jesperKarlfeldt/VO2_Mask/arduino v1.1/README.md

Code and other info related to arduino v1.1
