jesperKarlfeldt/VO2_Mask/Images/3Mmask.jpg

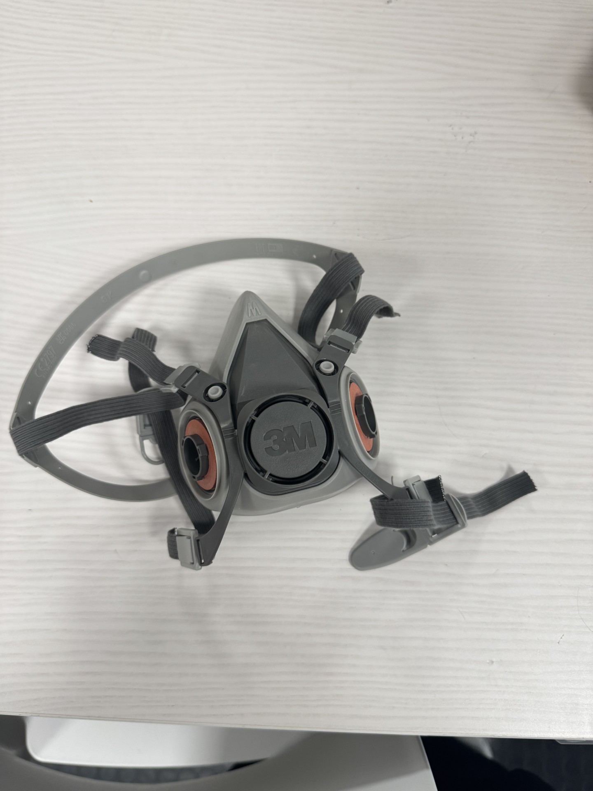
Images/3Mmask.jpg
