jesperKarlfeldt/VO2_Mask/Images/KablageEfter (1).jpg

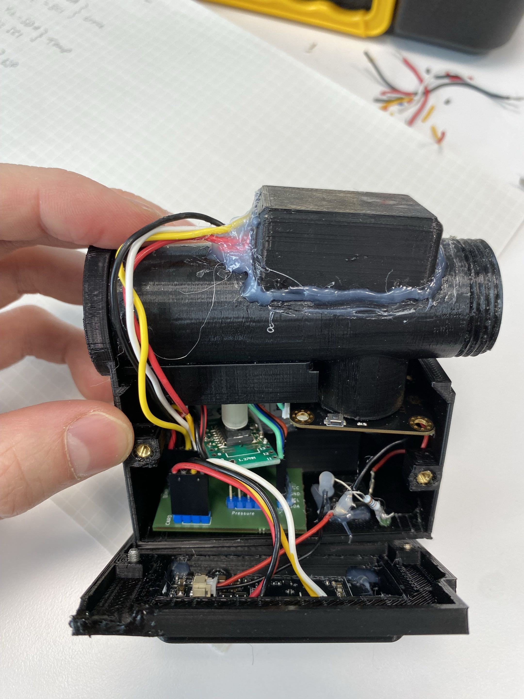
Images/KablageEfter (1).jpg
