jesperKarlfeldt/VO2_Mask/Images/PCB (1).png

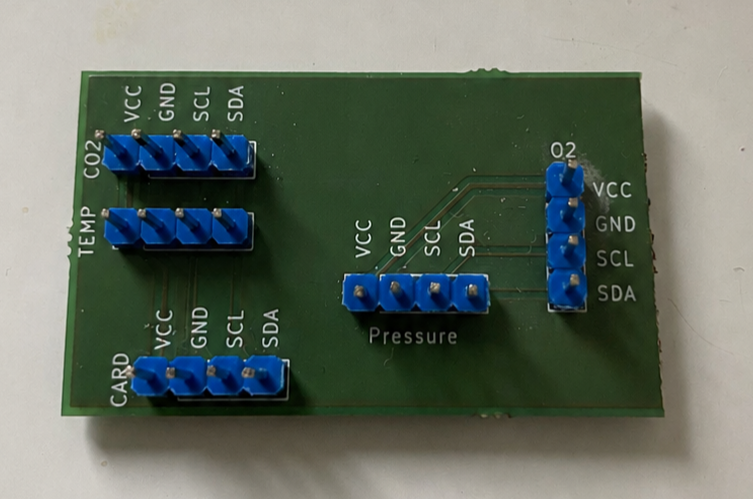
Images/PCB (1).png
