jesperKarlfeldt/VO2_Mask/BOM.md

## Bill of Materials

### USA

| Item | Description/Details | Source | Est Cost |
| --- | --- | --- | --- |
| board (the brain) | ESP32 T-Display, 16MB CH9102F | [Amazon](https://www.amazon.com/gp/product/B099MPFJ9M/) | $19 |
| battery| Lipo Battery, 1000 Mah, E503450 3.7v |  [Amazon](https://www.amazon.com/gp/product/B07BTV3W87/ref=ox_sc_act_title_1?smid=A132D7PL1YID8X&psc=1) | $12 |
| pressure sensor | BMP280, calculate air density |  [Amazon](https://www.amazon.com/gp/product/B01ICN5QPU/ref=ox_sc_act_title_1?smid=A30QSGOJR8LMXA&psc=1) | $6 |
| screws | 2 x M3 x 8mm | [Amazon](https://www.amazon.com/Hilitchi-510-Pcs-Button-Socket-Assortment/dp/B073SWNV5N/) | $15 for kit |
| threaded inserts (original design only) | M3 x 8 x 5mm | [Amazon](https://www.amazon.com/gp/product/B096MD67WB/) | $18 for kit |
| aquarium tubing (original design only) | standard 3/16", 4mm inside diameter (ID) |  [Amazon](https://www.amazon.com/AQUANEAT-Standard-Airline-Aquarium-PREMIUM/dp/B01N8SNNOI/) | $6 |
| o-ring | for oxygen sensor, 22x19x1.5mm | [Amazon](https://www.amazon.com/uxcell-Silicone-Rings-Diameter-Gasket/dp/B082STZ4XL?th=1) | $7 for 30 |
| jumper wire | for making board-sensor connections | [Amazon](https://www.amazon.com/TUOFENG-Hookup-Wires-6-Different-Colored/dp/B07TX6BX47?th=1) | $15 |
| oxygen sensor | Gravity: I2C Oxygen Sensor |  [DF Robot](https://www.dfrobot.com/product-2052.html) | $75 |
| differential pressure sensor | Omron--D6F-PH0025AD2 |  [Digikey](https://www.digikey.com/en/products/detail/omron-electronics-inc-emc-div/d6f-ph0025amd2/15197363) | $28 |
| cable for diff press sensor | DF-CABLE3 |  [Digikey](https://www.digikey.com/en/products/detail/omron-electronics-inc-emc-div/D6F-CABLE3/9471785) | $12 |
| mask | half mask, particulate matter, 6200/07025 | [Digikey](https://www.digikey.com/en/products/detail/3m/6200-07025/7693860) | $22 |
| CO2 sensor | SCD30 |  [Digikey](https://www.digikey.com/en/products/detail/sensirion-ag/SCD30/8445334) | $62 |
| on/off switch | mini push button |  [Adafruit](https://www.adafruit.com/product/1683)| $6 |

### EU

| Item | Description/Details | Source | Est Cost (€) |
| --- | --- | --- | --- |
| board (the brain) | ESP32 T-Display, 16MB CH9102F | [Amazon](https://www.amazon.de/-/en/gp/product/B099MPFJ9M) | €23 |
| battery| Lipo Battery, 1000 Mah, E503450 3.7v |  [Amazon](https://www.amazon.de/-/en/gp/product/B09GK98KZK) | €18 |
| diff pressure sensor | SM9233-BCE-S-250-002, calculate air density | [Mouser](https://www.mouser.se/ProductDetail/TE-Connectivity-SMI/SM9336-BCE-S-250-000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) | $47 |
| screws | 2 x M3 x 8mm | [Amazon](https://www.amazon.de/-/en/340pcs-Stainless-Screws-Button-Assortment/dp/B08H24T1DJ) | €9 for kit |
| threaded inserts (original design only) | M3 x 8 x 5mm | [Amazon](amazon.de/gp/product/B09ZHSGHXD) | tbd |
| aquarium tubing (original design only) | standard 3/16", 4mm inside diameter (ID) | [eBay](http://ebay.de/itm/183220505584?var=691579886173) | tbd |
| Silicone Tubing | 2mm ID x 4mm OD |  [Amazon](https://www.amazon.com/Quickun-Silicone-Brewing-Kegerator-Aquaponics/dp/B08BRJS5GD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) | $6 |
| o-ring | for oxygen sensor, 22x19x1.5mm | [Amazon](https://www.amazon.de/-/en/gp/product/B00AKW4MM0) | €5 for 10 |
| jumper wire | for making board-sensor connections | [eBay1](ebay.de/itm/184844268251) [eBay2](ebay.de/itm/184844268251) | tbd |
| oxygen sensor | Gravity: I2C Oxygen Sensor |  [Mouser](https://eu.mouser.com/ProductDetail/426-SEN0322) | €49 |
| mask | half mask, particulate matter, 6200/07025 | [Amazon](https://www.amazon.de/-/en/gp/product/B005HK05L2) | €21 |
| CO2 sensor | SCD30 |  [Mouser](https://www.mouser.se/ProductDetail/Mikroe/MIKROE-4725?qs=Li%252BoUPsLEnsKaKlNBnHiog%3D%3D) | €110 |
| on/off switch | mini push button |  [Mouser](https://eu.mouser.com/ProductDetail/Adafruit/1683)| €2 |

Prices are rounded and exclude VAT.
