jesperKarlfeldt/VO2_Mask/3d-print-files/v1/MainBody.3mf

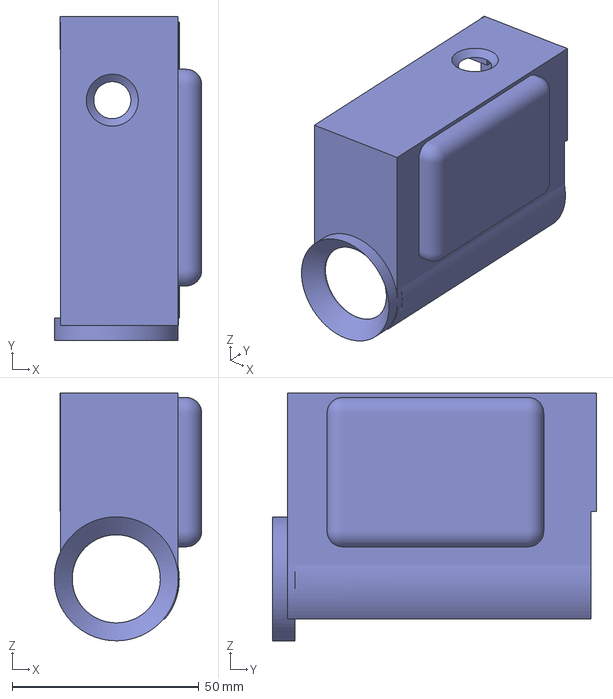
[picture p9: CAD file, 2026-05-20]
3d-print-files/v1/MainBody.3mf
39.5 x 86.8 x 66.3 mm
