jesperKarlfeldt/VO2_Mask/3d-print-files/v1/button.3mf

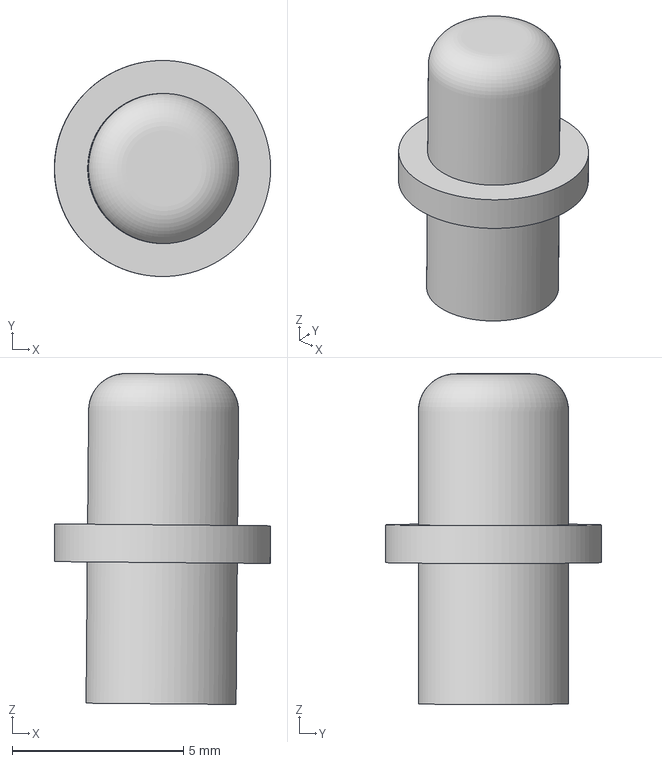
[picture p10: CAD file, 2026-05-20]
3d-print-files/v1/button.3mf
6.31 x 6.30 x 9.66 mm
