jesperKarlfeldt/VO2_Mask/3d-print-files/v1/CO2_upgrade/Venturi CO2 16mm.3mf

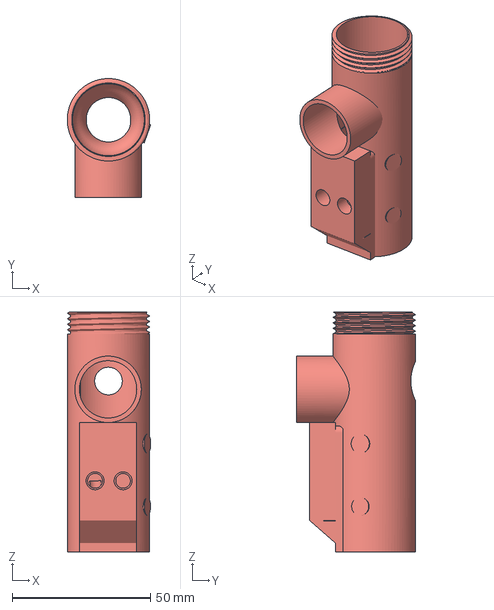
[picture p11: CAD file, 2026-05-20]
3d-print-files/v1/CO2_upgrade/Venturi CO2 16mm.3mf
30.2 x 43.0 x 86.8 mm
