jesperKarlfeldt/VO2_Mask/3d-print-files/v1/CO2_upgrade/SCD30 Cover.3mf

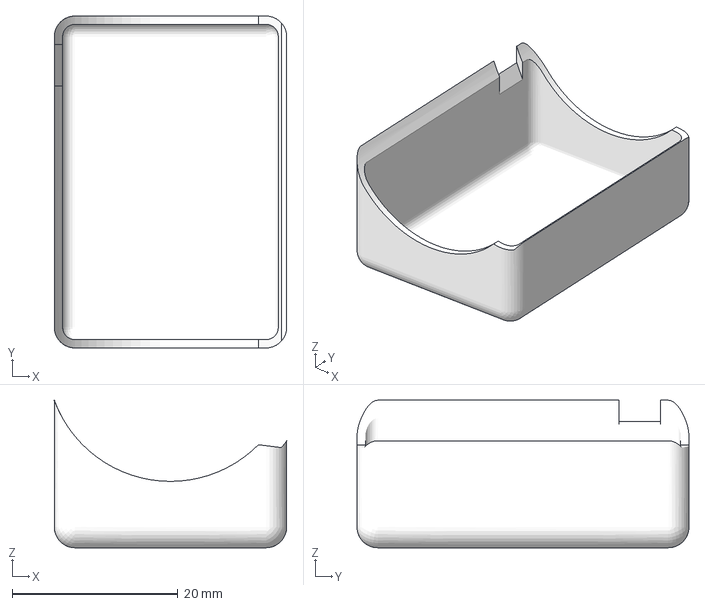
[picture p12: CAD file, 2026-05-20]
3d-print-files/v1/CO2_upgrade/SCD30 Cover.3mf
28.0 x 40.0 x 17.8 mm
