jesperKarlfeldt/VO2_Mask/3d-print-files/v1/MaskAttachment.3mf

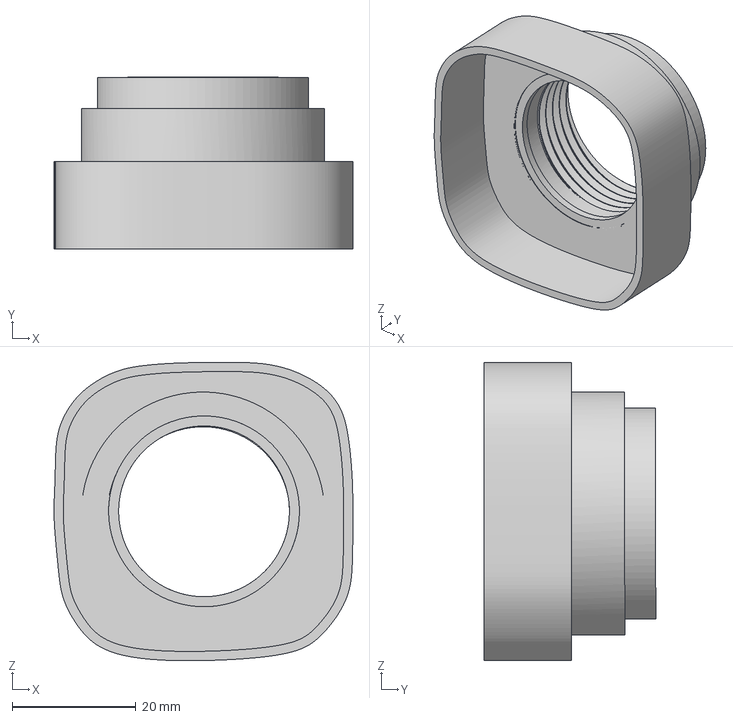
[picture p13: CAD file, 2026-05-20]
3d-print-files/v1/MaskAttachment.3mf
48.2 x 27.7 x 48.2 mm
