jesperKarlfeldt/VO2_Mask/3d-print-files/v1/ComputerCover.3mf

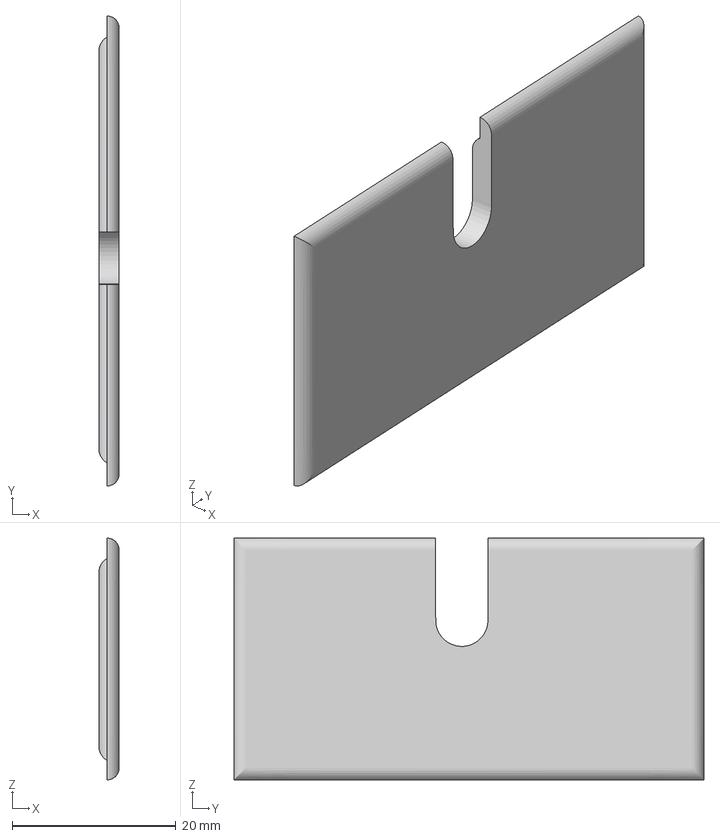
[picture p14: CAD file, 2026-05-20]
3d-print-files/v1/ComputerCover.3mf
2.49 x 57.5 x 29.6 mm
