jesperKarlfeldt/VO2_Mask/3d-print-files/v1/buttonHousing.3mf

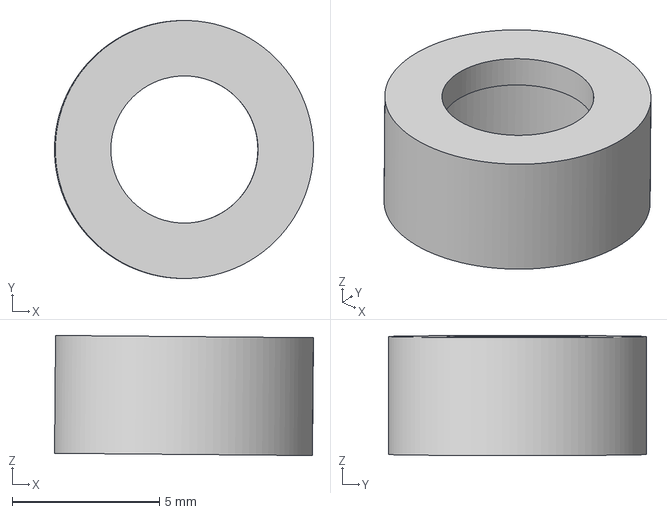
[picture p15: CAD file, 2026-05-20]
3d-print-files/v1/buttonHousing.3mf
8.79 x 8.75 x 4.08 mm
