jesperKarlfeldt/VO2_Mask/3d-print-files/v1/SideComputer.3mf

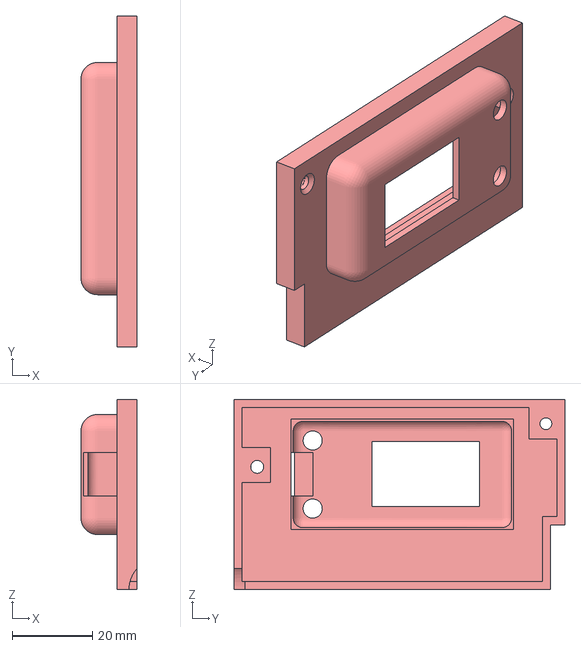
[picture p16: CAD file, 2026-05-20]
3d-print-files/v1/SideComputer.3mf
14.0 x 82.6 x 47.6 mm
