jesperKarlfeldt/VO2_Mask/(list of files, cad)

Other CAD files:
3d-print-files/v1/CO2_upgrade/Venturi CO2 20mm.3mf
3d-print-files/v1/VenturiSensor.3mf
