jesperKarlfeldt/VO2_Mask/papers/VO2MaxMask_presentation.pdf

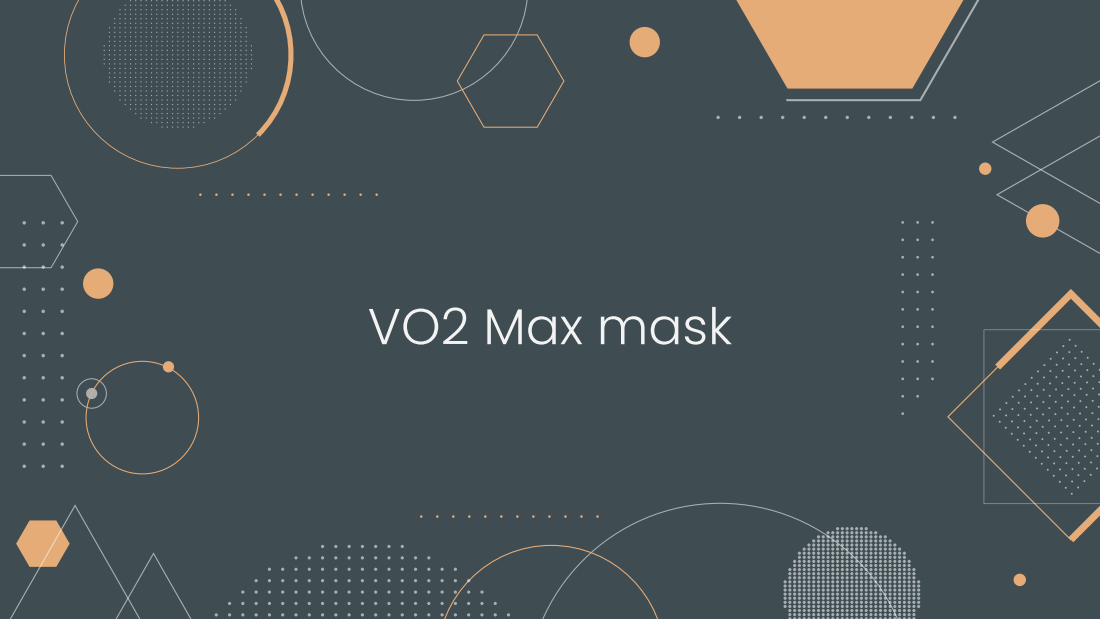
[picture p17: page 1]
VO2 Max mask

### Project Introduction

01.

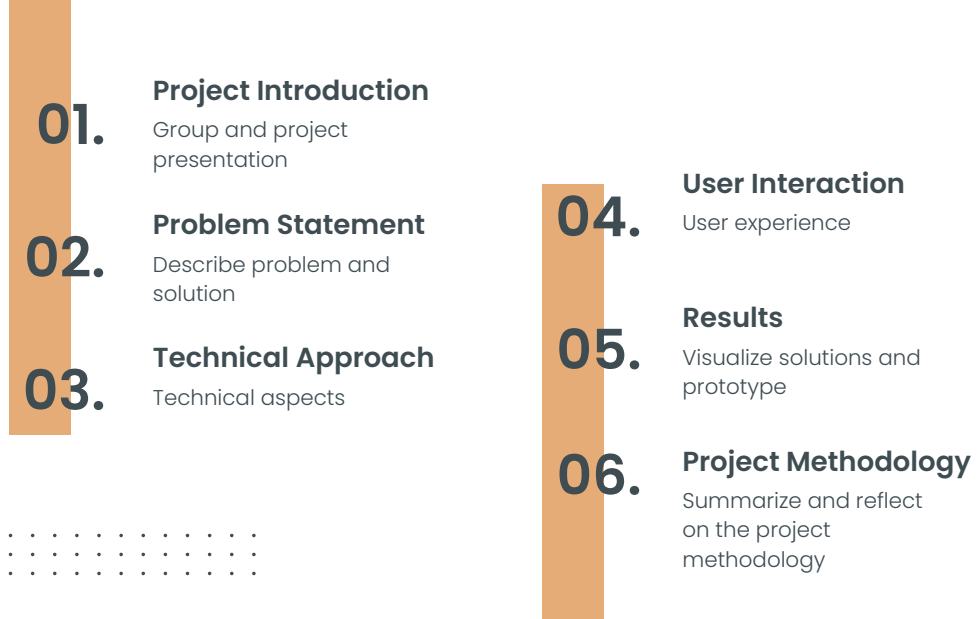
[picture p18: page 2]
Group and project presentation; Problem Statement; User Interaction User experience; 06. Project Methodology

Describe problem and
solution
Technical Approach
Technical aspects

Results
Visualize solutions and
prototype

Summarize and reflect
on the project
methodology

## Introduction

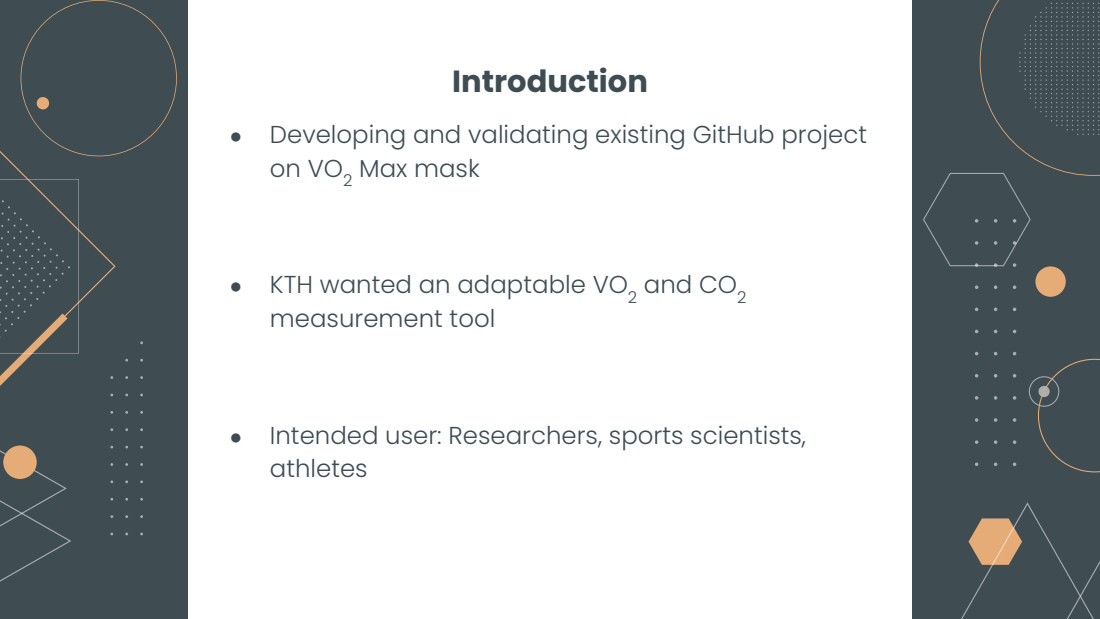
[picture p19: page 3]
Max mask; and CO2

● Developing and validating existing GitHub project

● KTH wanted an adaptable VO2
measurement tool

● Intended user: Researchers, sports scientists,
athletes

## Problem Statement

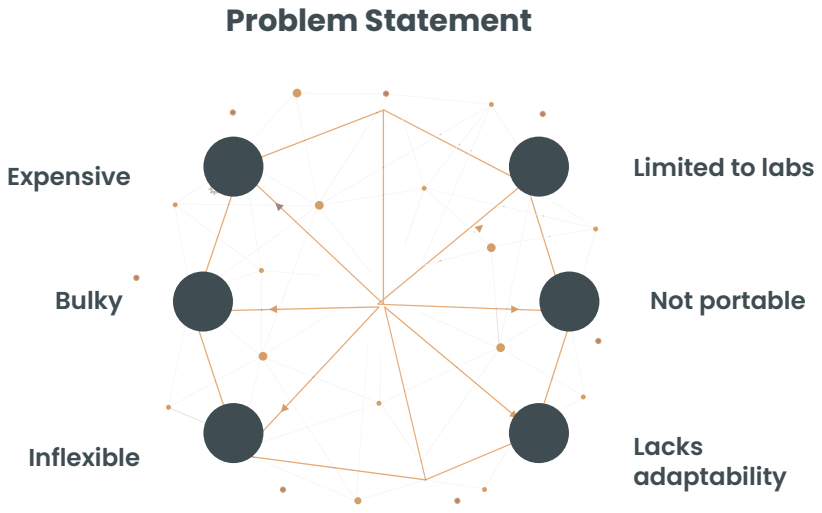
[picture p20: page 4]
Expensive; Limited to labs; Bulky; Not portable; Inflexible; Lacks; adaptability

## Technical Approach

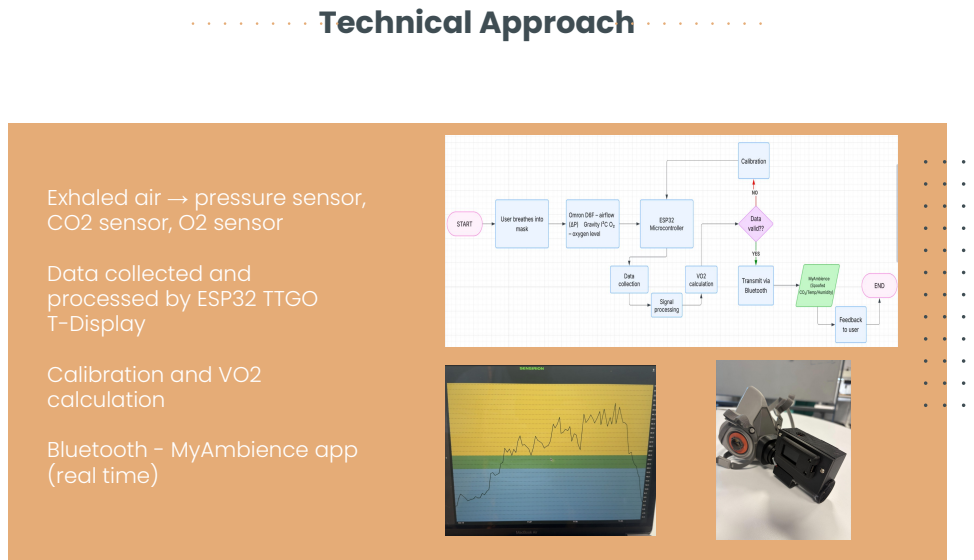
[picture p21: page 5]

Exhaled air → pressure sensor,
CO2 sensor, O2 sensor
Data collected and
processed by ESP32 TTGO
T-Display
Calibration and VO2
calculation
Bluetooth - MyAmbience app
(real time)

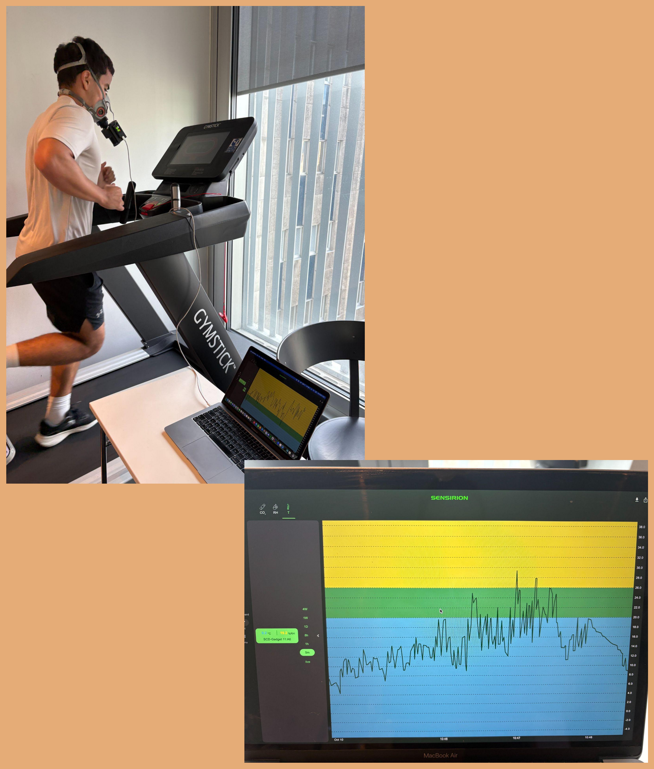
[picture p22: figure]

Input basic details (e.g. weight, ID )

## User Interaction

My Ambiance app

- System automatically measures airflow, O2

uptake, and CO2

output
through sensors
- Data is processed by the mask system and sent wirelessly to the app
- Subject gradually increases workload
- Real time feedback is shown in the app

## Results

1

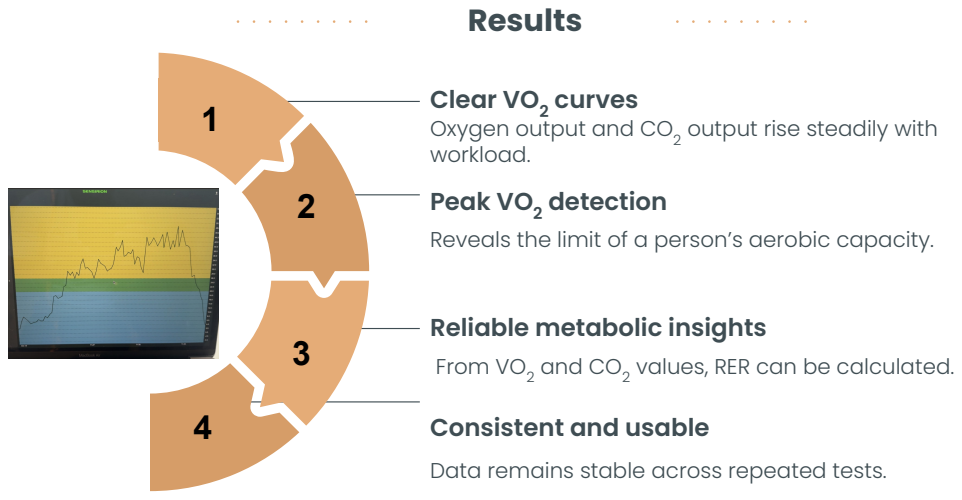
[picture p23: page 7]
Clear VO2; curves; detection; Oxygen output and CO2 workload.; and CO2

output rise steadily with

Peak VO2
Reveals the limit of a person’s aerobic capacity.

Reliable metabolic insights
From VO2
Consistent and usable
Data remains stable across repeated tests.

values, RER can be calculated.

### Project Methodology

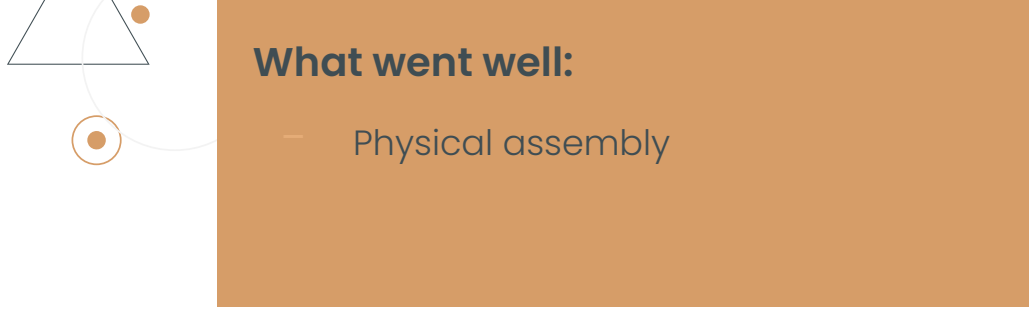
[picture p24: figure]
What went well: - Physical assembly

Challenges:

Future improvements:

- Integrating new sensors
- Battery
- On/Off switch
- Different mask sizes
- Larger test group

Focus:
Hardware assembly
Software integration

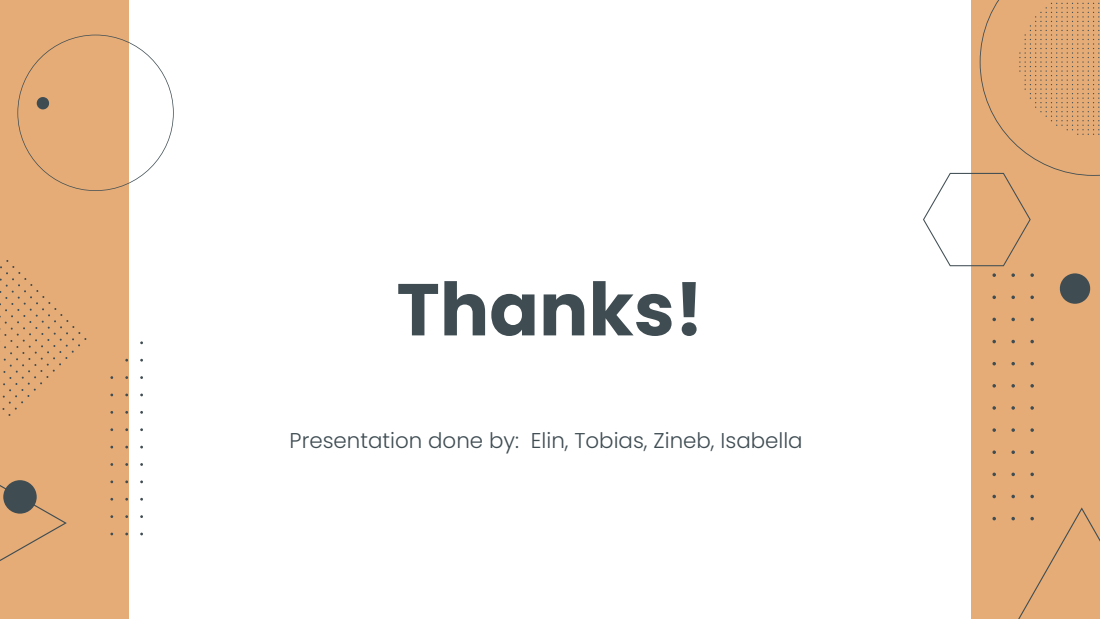
[picture p25: page 9]
Thanks!

Presentation done by: Elin, Tobias, Zineb, Isabella
