jesperKarlfeldt/VO2_Mask/Images/Mask_Sensor.JPG

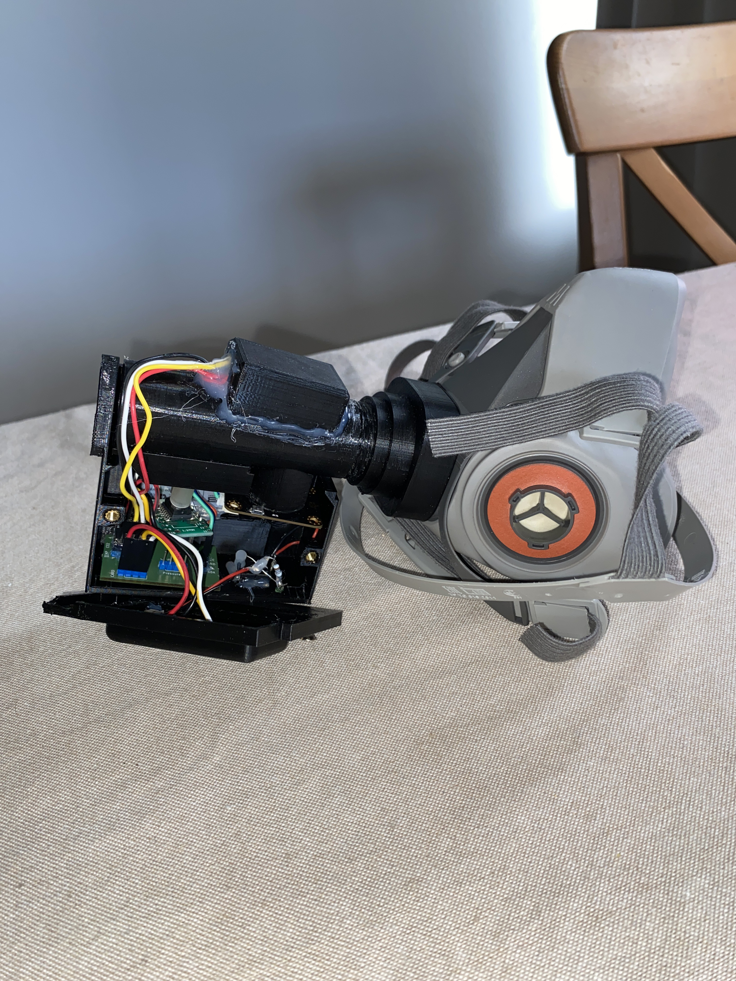
Images/Mask_Sensor.JPG
